D-LCR/A1_Main-Board/README.md

# D-LCR_A1_Main-Board
LCR Meter Analogue Main Board
