D-LCR/A1_Main-Board/Circuit/Main Board.kicad_pcb

## KiCad design Circuit/Main Board.kicad_pcb (2026-05-05)

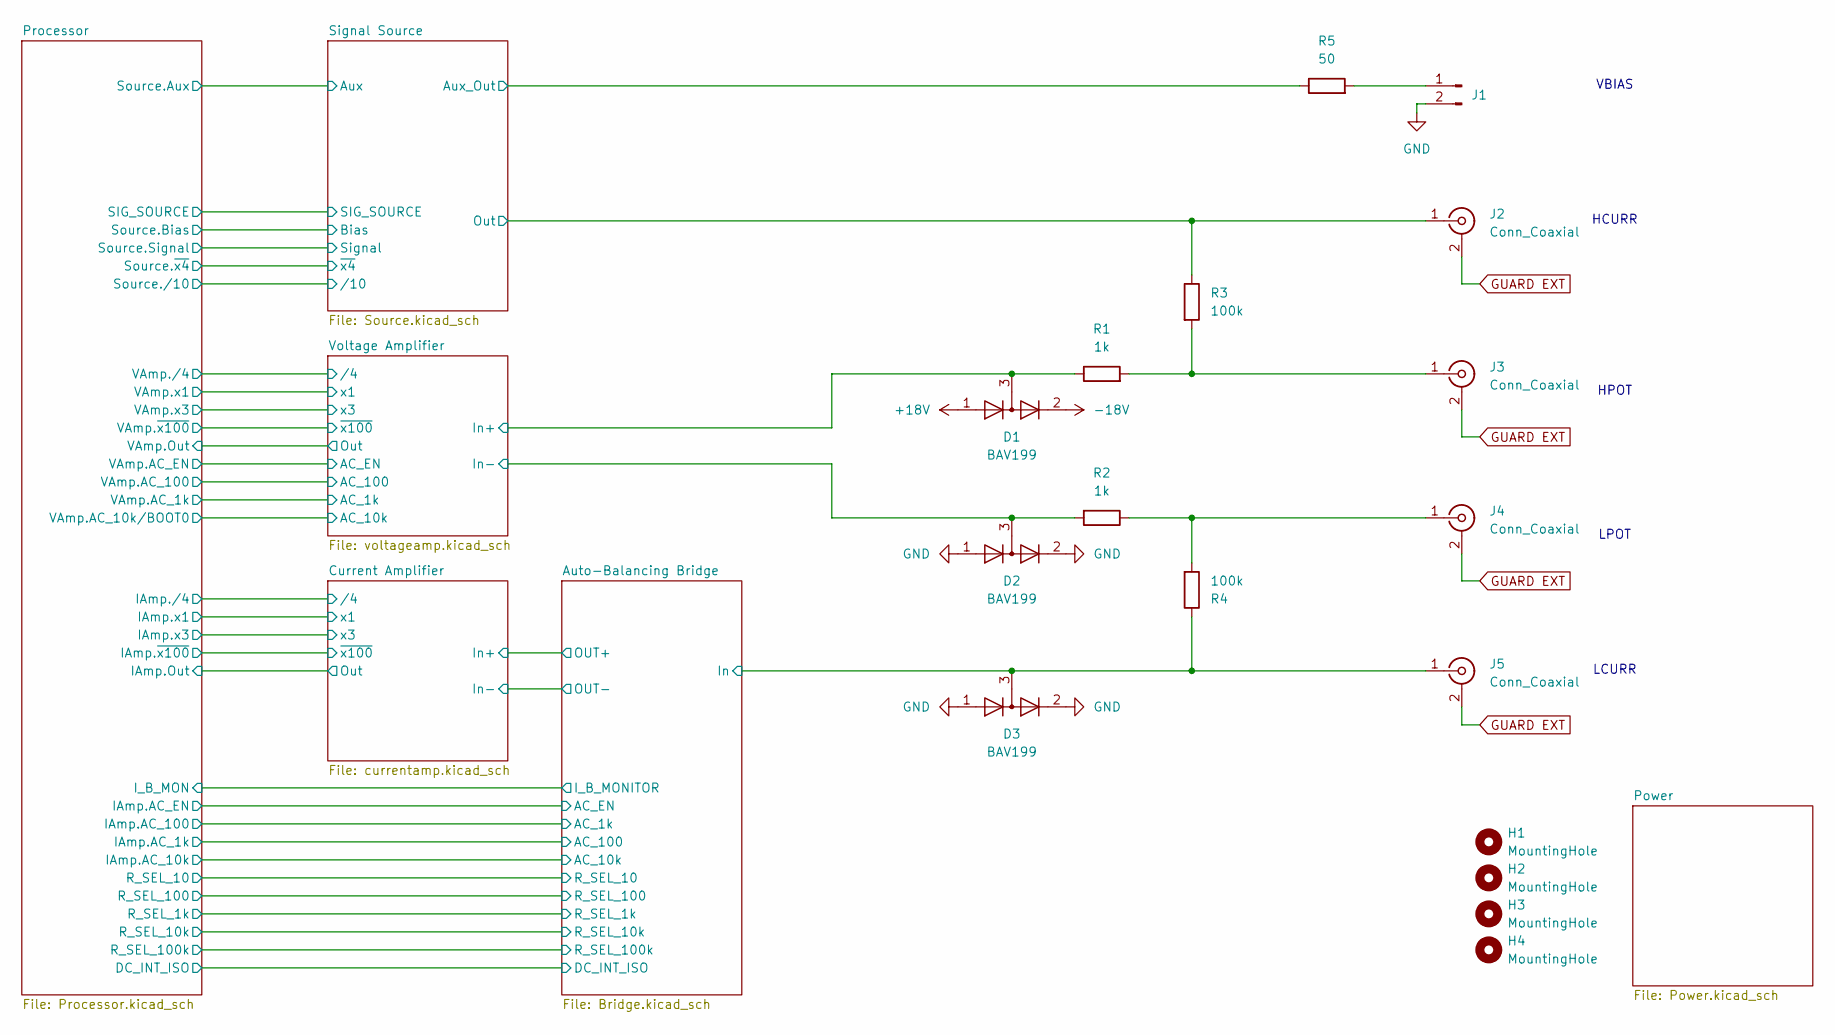
[picture p1: schematic Main Board.kicad_sch, Root]

Parts:
D1, D2, D3: BAV199; SOT-23
H1, H2, H3, H4: MountingHole; MountingHole_3.2mm_M3
J1: Conn_01x02_Pin; Molex_KK-254_AE-6410-02A_1x02_P2.54mm_Vertical
J2, J3, J4, J5: Conn_Coaxial; BNC_Amphenol_B6252HB-NPP3G-50_Horizontal
R1, R2: 1k; R_0805_2012Metric
R3, R4: 100k; R_0805_2012Metric
R5: 50; R_0805_2012Metric

Connections:
+18V: D1.1 (K); also elsewhere on the board
-18V: D1.2 (A); also elsewhere on the board
/Auto-Balancing Bridge/TIA_SUM: D3.3 (K), J5.1 (In), R4.1; also elsewhere on the board
/Signal Source/Aux_Out: R5.1; also elsewhere on the board
/Signal Source/Out: J2.1 (In), R3.1; also elsewhere on the board
/Voltage Amplifier/In+: D1.3 (K), R1.1; also elsewhere on the board
/Voltage Amplifier/In-: D2.3 (K), R2.2; also elsewhere on the board
GND: D2.1 (K), D2.2 (A), D3.1 (K), D3.2 (A), J1.2; also elsewhere on the board
GUARD EXT: J2.2 (Ext), J3.2 (Ext), J4.2 (Ext), J5.2 (Ext); also elsewhere on the board
unnamed: J1.1, R5.2
unnamed: J3.1 (In), R1.2, R3.2
unnamed: J4.1 (In), R2.1, R4.2

Notes on the sheet:
LPOT
HCURR
VBIAS
LCURR
HPOT

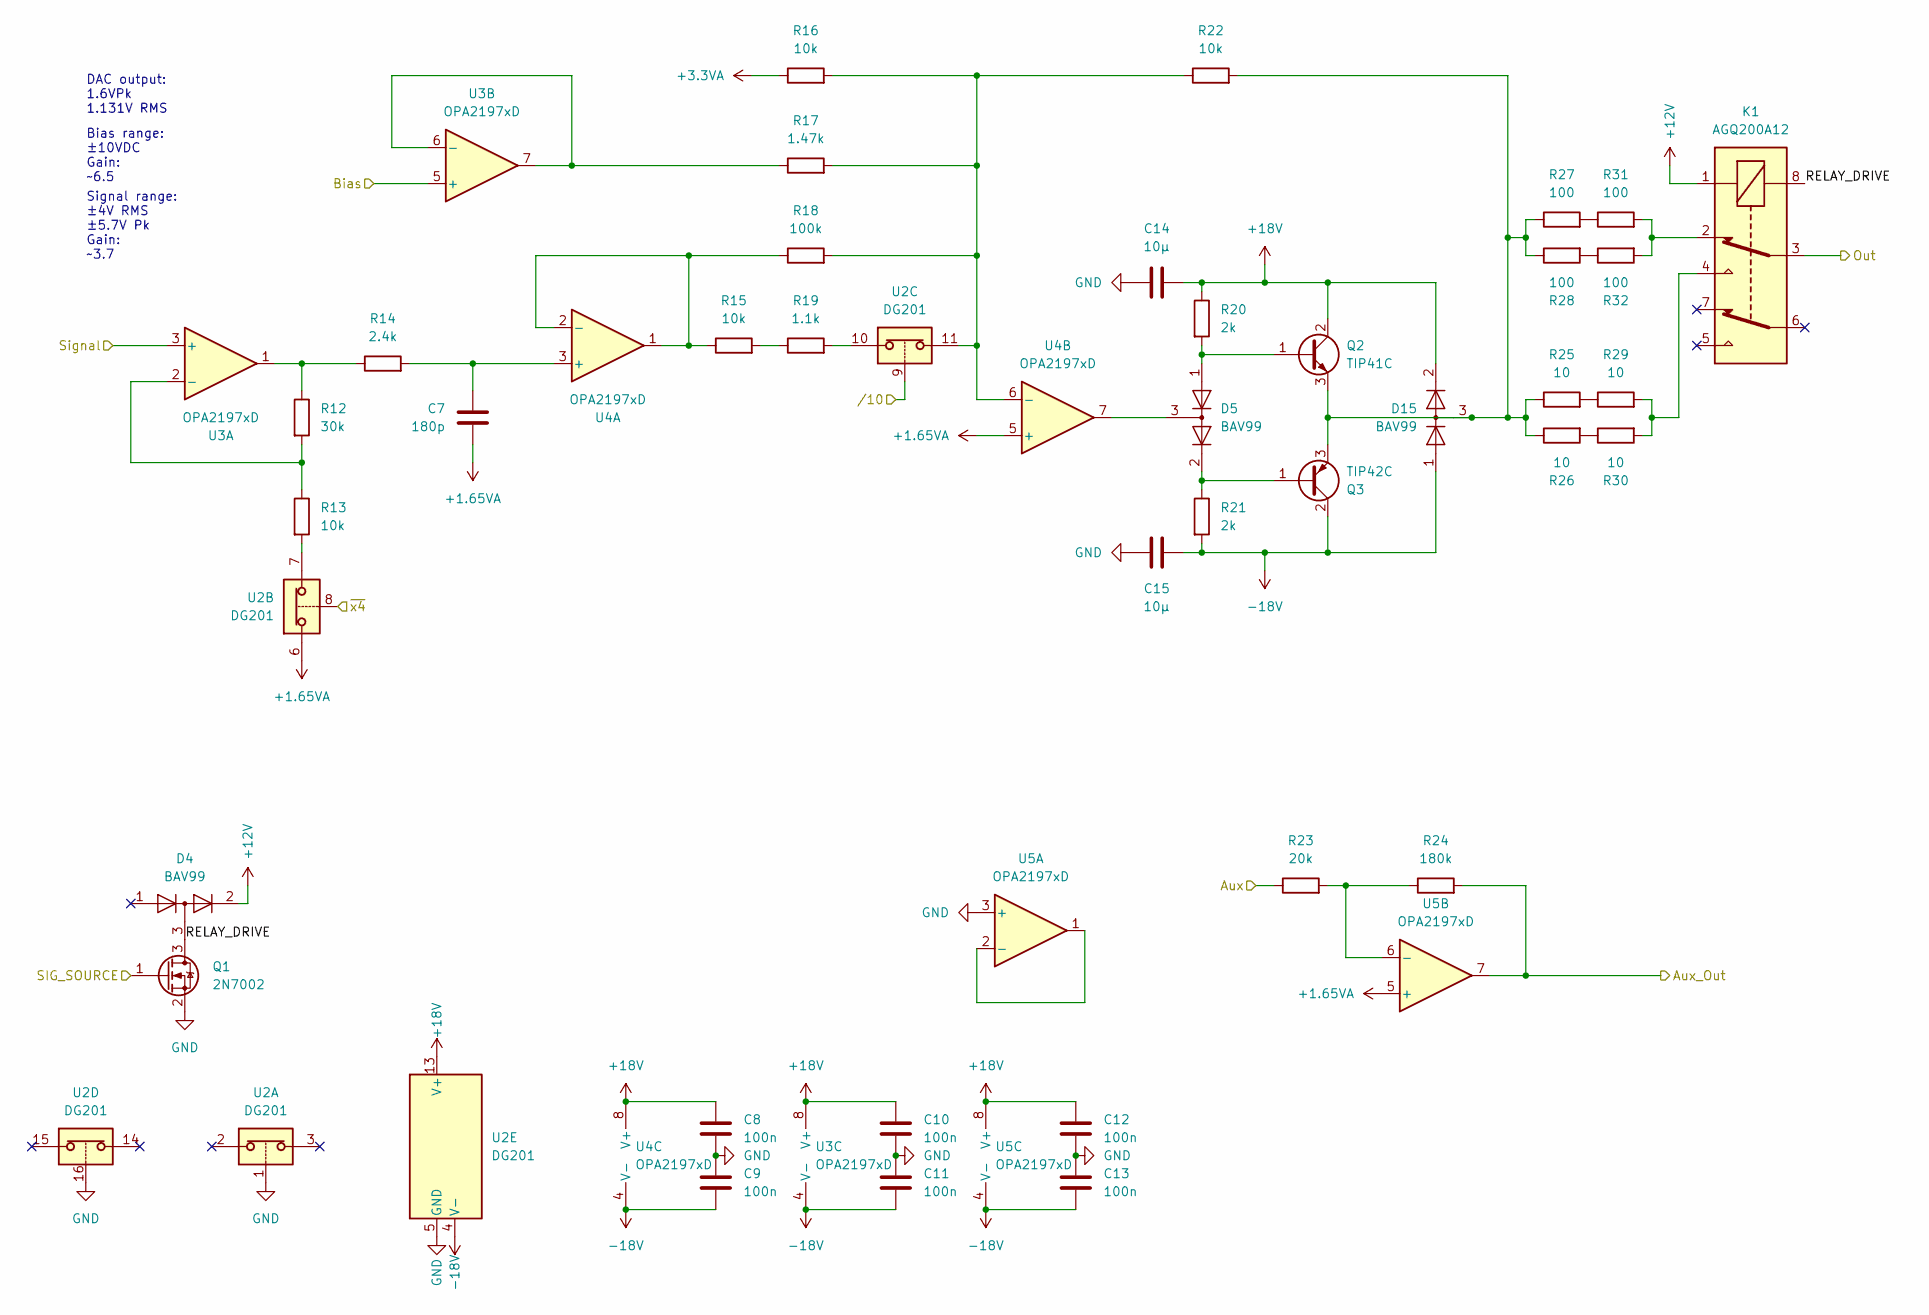
[picture p2: schematic Source.kicad_sch, Signal Source]

Parts:
C7: 180p; C_0805_2012Metric
C8, C9, C10, C11, C12, C13: 100n; C_0805_2012Metric
C14, C15: 10µ; C_0805_2012Metric
D4, D5, D15: BAV99; SOT-23
K1: AGQ200A12; RELAY_AGQ_A_PAN; Mouser Part Number 769-AGQ200A12
Q1: 2N7002; SOT-23
Q2: TIP41C; TO-220-3_Vertical
Q3: TIP42C; TO-220-3_Vertical
R12: 30k; R_0805_2012Metric
R13, R15, R16, R22: 10k; R_0805_2012Metric
R14: 2.4k; R_0805_2012Metric
R17: 1.47k; R_0805_2012Metric
R18: 100k; R_0805_2012Metric
R19: 1.1k; R_0805_2012Metric
R20, R21: 2k; R_0805_2012Metric
R23: 20k; R_0805_2012Metric
R24: 180k; R_0805_2012Metric
R25, R26, R29, R30: 10; R_2512_6332Metric
R27, R28, R31, R32: 100; R_0805_2012Metric
U2: DG201; SOIC-16_3.9x9.9mm_P1.27mm
U3, U4, U5: OPA2197xD; SOIC-8_3.9x4.9mm_P1.27mm

Connections:
+1.65VA: C7.2, U2.6, U4.5 (+), U5.5 (+); also elsewhere on the board
+3.3VA: R16.1; also elsewhere on the board
+12V: D4.2 (A), K1.1; also elsewhere on the board
+18V: C8.1, C10.1, C12.1, C14.2, D15.2 (A), Q2.2 (C), R20.1, U2.13 (V+), U3.8 (V+), U4.8 (V+), U5.8 (V+); also elsewhere on the board
-18V: C9.2, C11.2, C13.2, C15.2, D15.1 (K), Q3.2 (C), R21.2, U2.4 (V-), U3.4 (V-), U4.4 (V-), U5.4 (V-); also elsewhere on the board
/Processor/SIG_SOURCE: Q1.1 (G); also elsewhere on the board
/Processor/Source.Aux: R23.1; also elsewhere on the board
/Processor/Source.Bias: U3.5 (+); also elsewhere on the board
/Processor/Source.Signal: U3.3 (+); also elsewhere on the board
/Processor/Source./10: U2.9; also elsewhere on the board
/Processor/Source.~x4: U2.8; also elsewhere on the board
/Signal Source/Aux_Out: R24.2, U5.7; also elsewhere on the board
/Signal Source/Out: K1.3; also elsewhere on the board
/Signal Source/RELAY_DRIVE: D4.3 (K), K1.8, Q1.3 (D)
GND: C8.2, C9.1, C10.2, C11.1, C12.2, C13.1, C14.1, C15.1, Q1.2 (S), U2.1, U2.5 (GND), U2.16, U5.3 (+); also elsewhere on the board
unnamed: D5.2 (A), Q3.1 (B), R21.1
unnamed: D5.3 (K), U4.7
unnamed: K1.2, R31.2, R32.2
unnamed: K1.4, R29.2, R30.2
unnamed: D5.1 (K), Q2.1 (B), R20.2
unnamed: D15.3 (K), Q2.3 (E), Q3.3 (E), R22.2, R25.1, R26.1, R27.1, R28.1
unnamed: R12.1, R14.1, U3.1
unnamed: R13.2, U2.7
unnamed: R15.2, R19.1
unnamed: R19.2, U2.10
unnamed: R25.2, R29.1
unnamed: R26.2, R30.1
unnamed: R27.2, R31.1
unnamed: R28.2, R32.1
unnamed: R12.2, R13.1, U3.2 (-)
unnamed: R17.1, U3.6 (-), U3.7
unnamed: C7.1, R14.2, U4.3 (+)
unnamed: R15.1, R18.1, U4.1, U4.2 (-)
unnamed: R16.2, R17.2, R18.2, R22.1, U2.11, U4.6 (-)
unnamed: U5.1, U5.2 (-)
unnamed: R23.2, R24.1, U5.6 (-)

Notes on the sheet:
Bias range: ±10VDC Gain: ~6.5
DAC output: 1.6VPk 1.131V RMS
Signal range: ±4V RMS ±5.7V Pk Gain: ~3.7

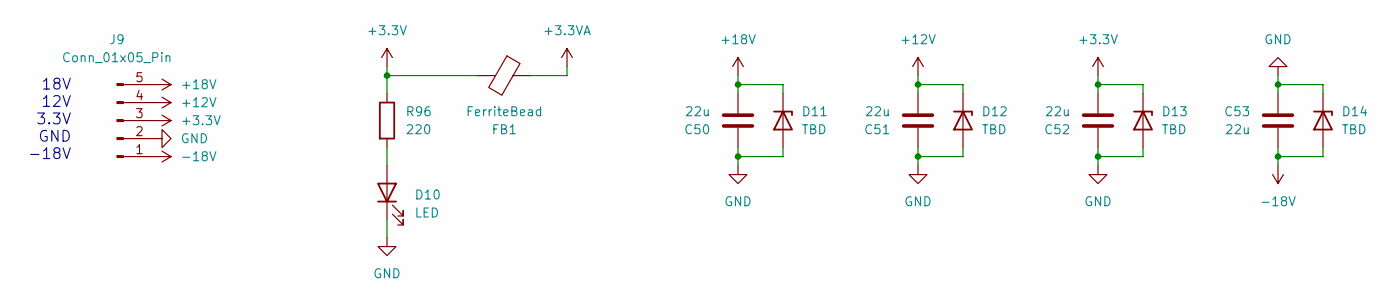
[picture p3: schematic Power.kicad_sch, Power Supply]

Parts:
C50, C51, C52, C53: 22u; C_1210_3225Metric
D10: LED; LED_0805_2012Metric
D11, D12, D13, D14: TBD; D_SMA
FB1: FerriteBead; L_0805_2012Metric
J9: Conn_01x05_Pin; Molex_KK-254_AE-6410-05A_1x05_P2.54mm_Vertical
R96: 220; R_0805_2012Metric

Connections:
+3.3V: C52.2, D13.1 (K), FB1.2, J9.3, R96.1; also elsewhere on the board
+3.3VA: FB1.1; also elsewhere on the board
+12V: C51.2, D12.1 (K), J9.4; also elsewhere on the board
+18V: C50.2, D11.1 (K), J9.5; also elsewhere on the board
-18V: C53.1, D14.2 (A), J9.1; also elsewhere on the board
GND: C50.1, C51.1, C52.1, C53.2, D10.1 (K), D11.2 (A), D12.2 (A), D13.2 (A), D14.1 (K), J9.2; also elsewhere on the board
unnamed: D10.2 (A), R96.2

Notes on the sheet:
18V 12V 3.3V GND -18V

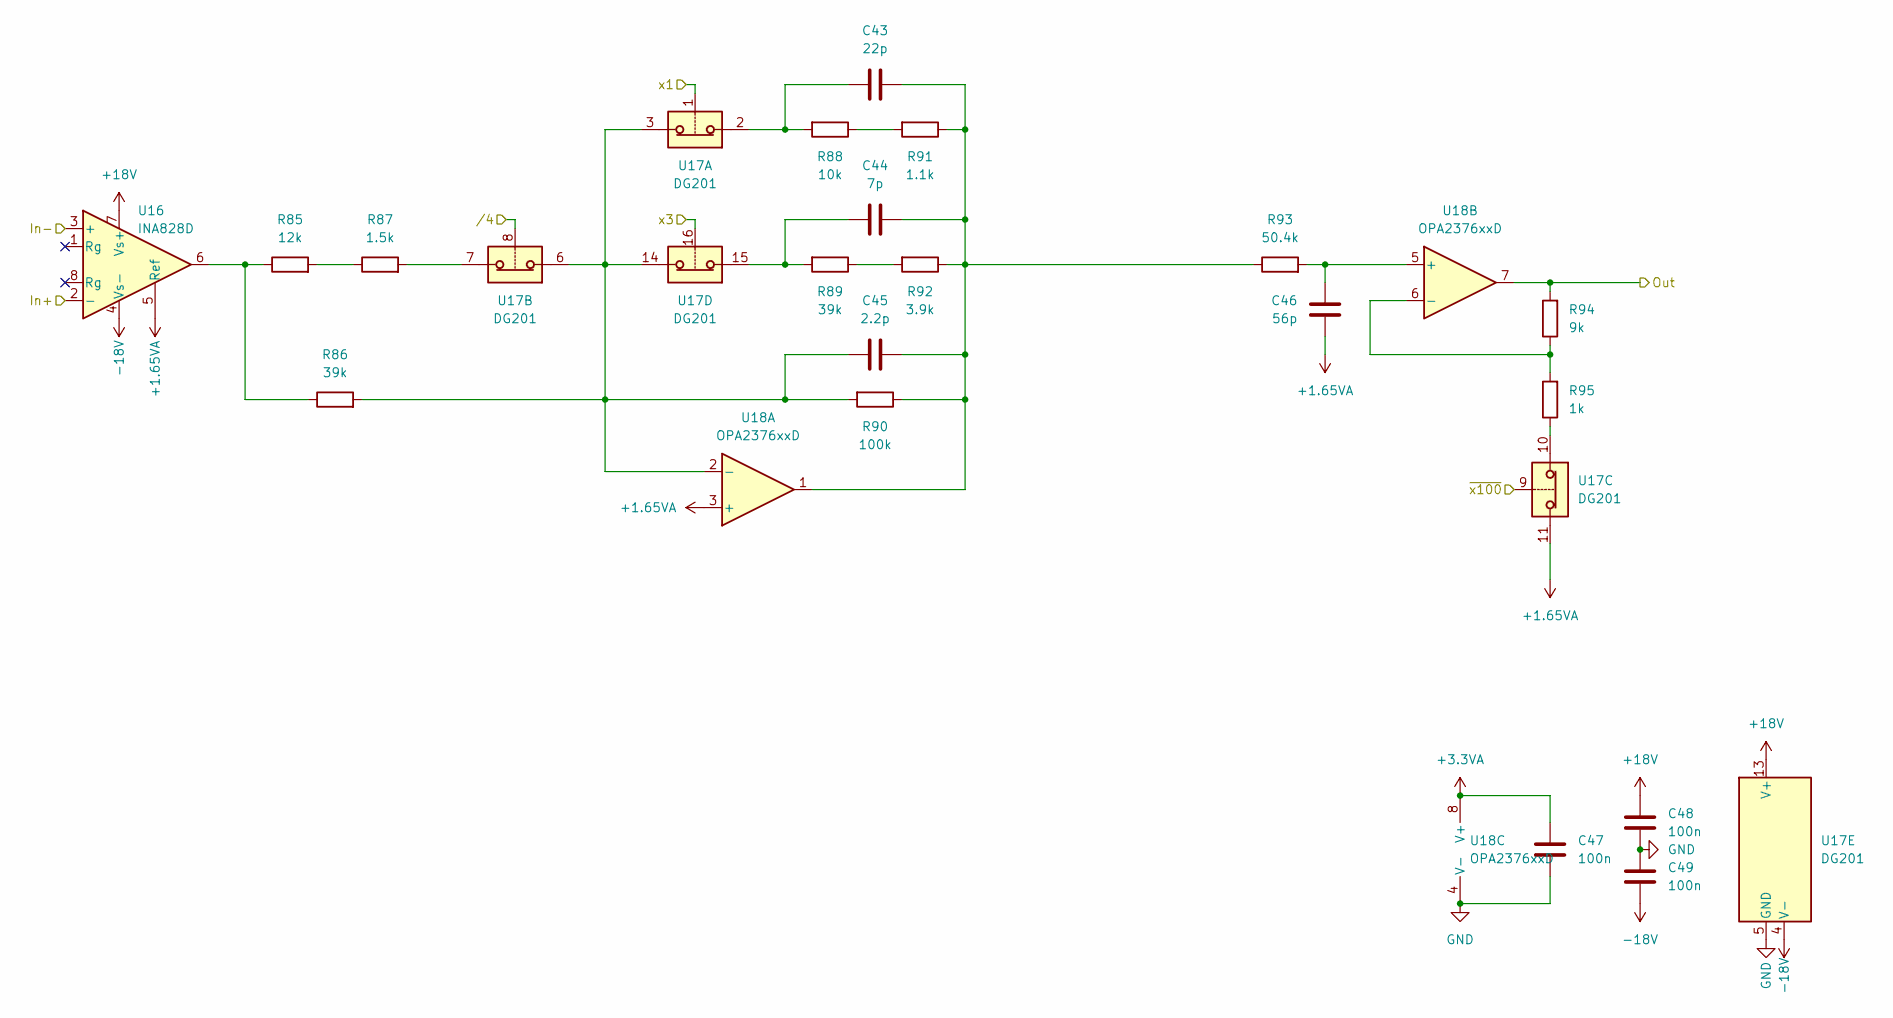
[picture p4: schematic currentamp.kicad_sch, Current Amplifier]

Parts:
C43: 22p; C_0805_2012Metric
C44: 7p; C_0805_2012Metric
C45: 2.2p; C_0805_2012Metric
C46: 56p; C_0805_2012Metric
C47, C48, C49: 100n; C_0805_2012Metric
R85: 12k; R_0805_2012Metric
R86, R89: 39k; R_0805_2012Metric
R87: 1.5k; R_0805_2012Metric
R88: 10k; R_0805_2012Metric
R90: 100k; R_0805_2012Metric
R91: 1.1k; R_0805_2012Metric
R92: 3.9k; R_0805_2012Metric
R93: 50.4k; R_0805_2012Metric
R94: 9k; R_0805_2012Metric
R95: 1k; R_0805_2012Metric
U16: INA828D; SOIC-8_3.9x4.9mm_P1.27mm
U17: DG201; SOIC-16_3.9x9.9mm_P1.27mm
U18: OPA2376xxD; SOIC-8_3.9x4.9mm_P1.27mm

Connections:
+1.65VA: C46.2, U16.5 (Ref), U17.11, U18.3 (+); also elsewhere on the board
+3.3VA: C47.1, U18.8 (V+); also elsewhere on the board
+18V: C48.1, U16.7 (Vs+), U17.13 (V+); also elsewhere on the board
-18V: C49.2, U16.4 (Vs-), U17.4 (V-); also elsewhere on the board
/Auto-Balancing Bridge/OUT+: U16.2 (-); also elsewhere on the board
/Auto-Balancing Bridge/TIA_SUM: U16.3 (+); also elsewhere on the board
/Current Amplifier/Out: R94.2, U18.7; also elsewhere on the board
/Current Amplifier/x1: U17.1; also elsewhere on the board
/Current Amplifier/x3: U17.16; also elsewhere on the board
/Current Amplifier//4: U17.8; also elsewhere on the board
/Current Amplifier/~x100: U17.9; also elsewhere on the board
GND: C47.2, C48.2, C49.1, U17.5 (GND), U18.4 (V-); also elsewhere on the board
unnamed: C43.1, R88.2, U17.2
unnamed: C43.2, C44.2, C45.2, R90.1, R91.1, R92.1, R93.1, U18.1
unnamed: C44.1, R89.2, U17.15
unnamed: R85.1, R86.1, U16.6
unnamed: R85.2, R87.1
unnamed: R87.2, U17.7
unnamed: R88.1, R91.2
unnamed: R89.1, R92.2
unnamed: R95.1, U17.10
unnamed: C45.1, R86.2, R90.2, U17.3, U17.6, U17.14, U18.2 (-)
unnamed: C46.1, R93.2, U18.5 (+)
unnamed: R94.1, R95.2, U18.6 (-)

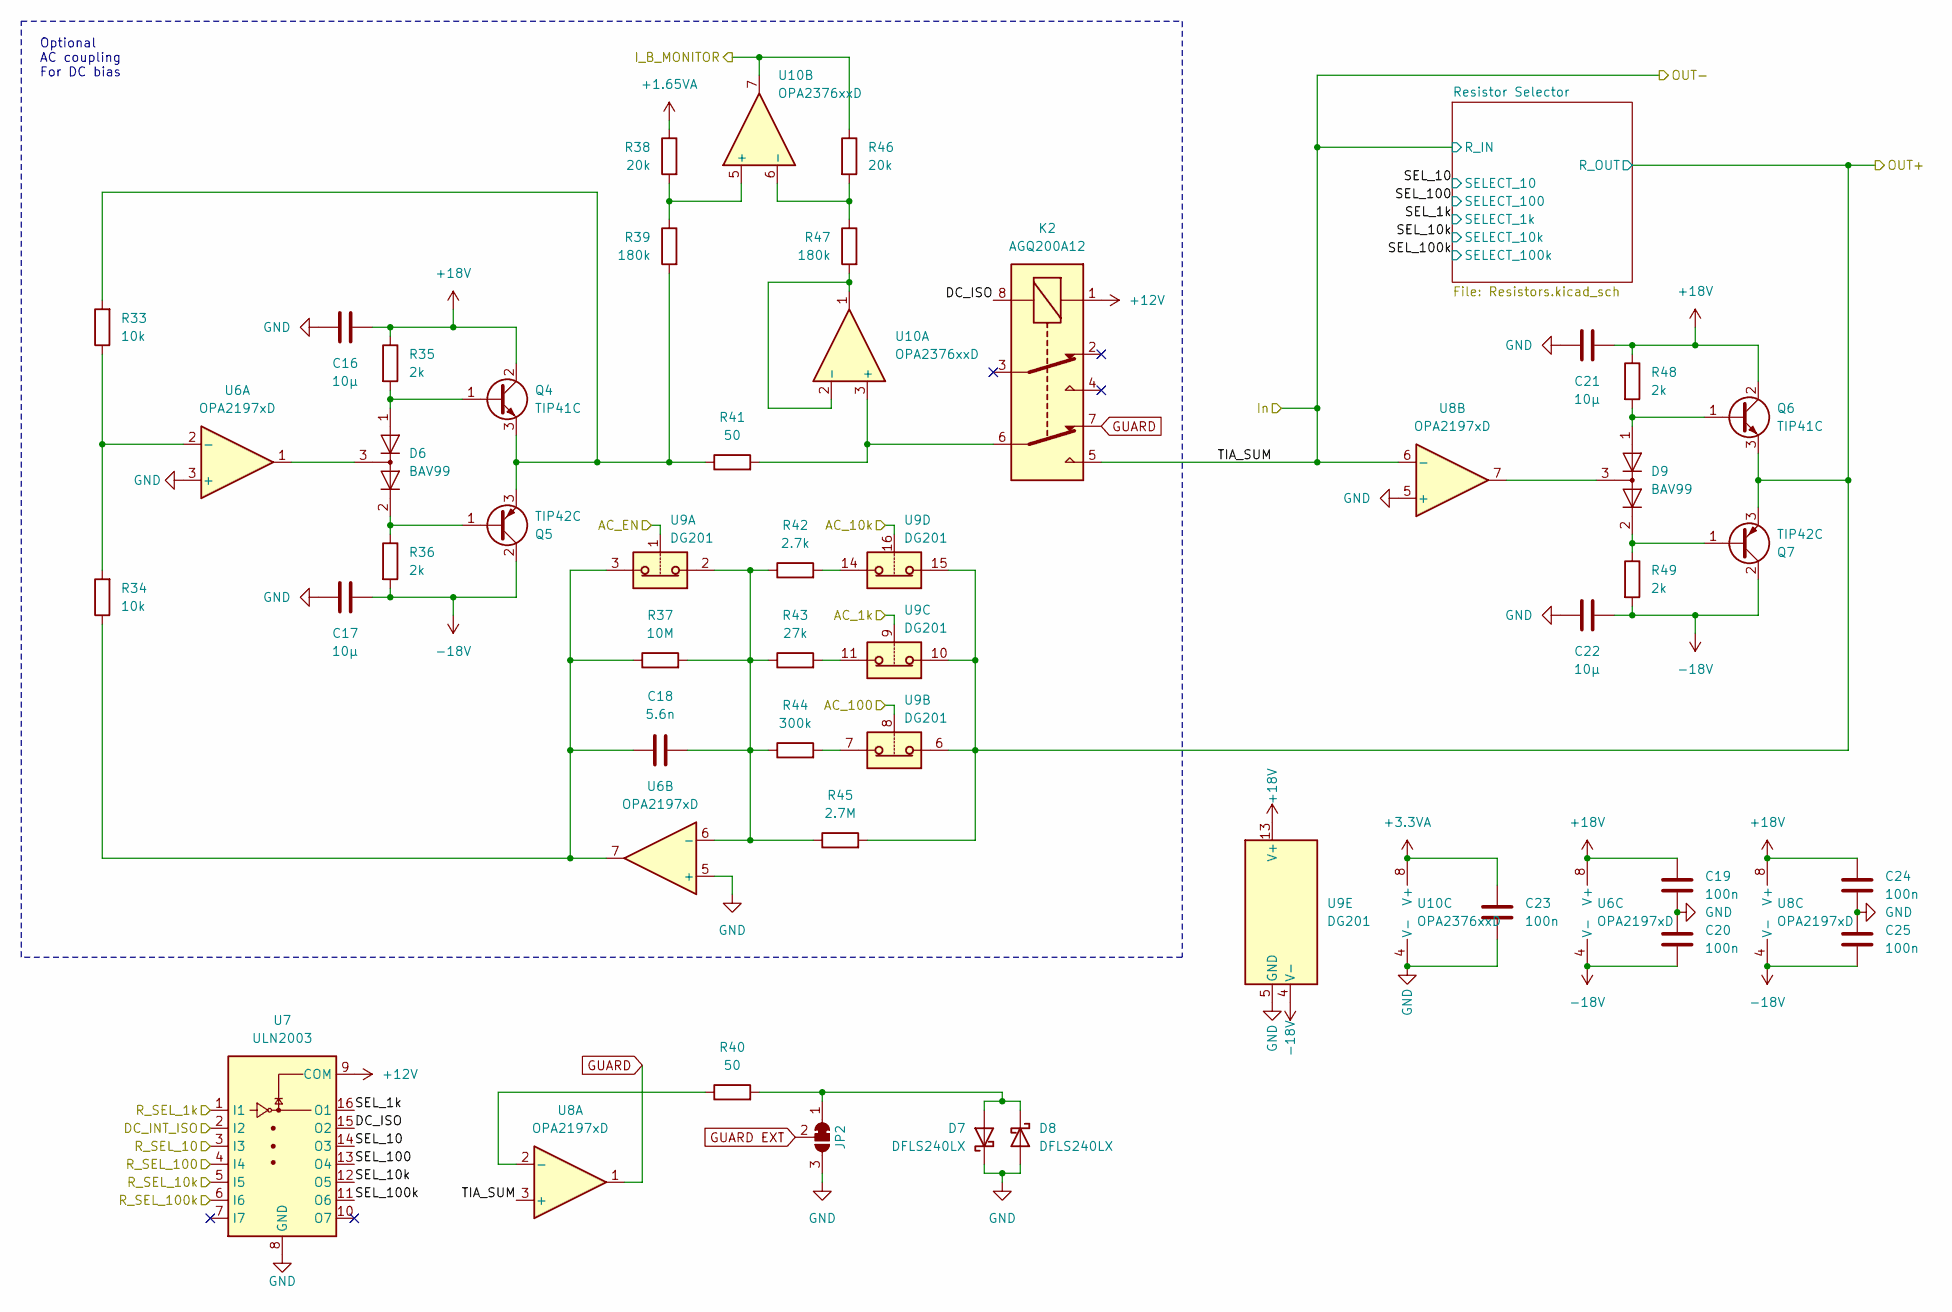
[picture p5: schematic Bridge.kicad_sch, Auto-Balancing Bridge]

Parts:
C16, C17, C21, C22: 10µ; C_0805_2012Metric
C18: 5.6n; C_0805_2012Metric
C19, C20, C23, C24, C25: 100n; C_0805_2012Metric
D6, D9: BAV99; SOT-23
D7, D8: DFLS240LX; D_PowerDI-123
JP2: SolderJumper_3_Bridged12; SolderJumper-3_P1.3mm_Bridged12_RoundedPad1.0x1.5mm
K2: AGQ200A12; RELAY_AGQ_A_PAN; Mouser Part Number 769-AGQ200A12
Q4, Q6: TIP41C; TO-220-3_Vertical
Q5, Q7: TIP42C; TO-220-3_Vertical
R33, R34: 10k; R_0805_2012Metric
R35, R36, R48, R49: 2k; R_0805_2012Metric
R37: 10M; R_0805_2012Metric
R38, R46: 20k; R_0805_2012Metric
R39, R47: 180k; R_0805_2012Metric
R40, R41: 50; R_0805_2012Metric
R42: 2.7k; R_0805_2012Metric
R43: 27k; R_0805_2012Metric
R44: 300k; R_0805_2012Metric
R45: 2.7M; R_0805_2012Metric
U6, U8: OPA2197xD; SOIC-8_3.9x4.9mm_P1.27mm
U7: ULN2003; SOIC-16_3.9x9.9mm_P1.27mm
U9: DG201; SOIC-16_3.9x9.9mm_P1.27mm
U10: OPA2376xxD; SOIC-8_3.9x4.9mm_P1.27mm

Connections:
+1.65VA: R38.1; also elsewhere on the board
+3.3VA: C23.1, U10.8 (V+); also elsewhere on the board
+12V: K2.1, U7.9 (COM); also elsewhere on the board
+18V: C16.2, C19.1, C21.2, C24.1, Q4.2 (C), Q6.2 (C), R35.1, R48.1, U6.8 (V+), U8.8 (V+), U9.13 (V+); also elsewhere on the board
-18V: C17.2, C20.2, C22.2, C25.2, Q5.2 (C), Q7.2 (C), R36.2, R49.2, U6.4 (V-), U8.4 (V-), U9.4 (V-); also elsewhere on the board
/Auto-Balancing Bridge/AC_1k: U9.9; also elsewhere on the board
/Auto-Balancing Bridge/AC_10k: U9.16; also elsewhere on the board
/Auto-Balancing Bridge/AC_100: U9.8; also elsewhere on the board
/Auto-Balancing Bridge/AC_EN: U9.1; also elsewhere on the board
/Auto-Balancing Bridge/DC_INT_ISO: U7.2 (I2); also elsewhere on the board
/Auto-Balancing Bridge/DC_ISO: K2.8, U7.15 (O2)
/Auto-Balancing Bridge/I_B_MONITOR: R46.1, U10.7; also elsewhere on the board
/Auto-Balancing Bridge/OUT+: Q6.3 (E), Q7.3 (E), R45.2, U9.6, U9.10, U9.15; also elsewhere on the board
/Auto-Balancing Bridge/R_SEL_1k: U7.1 (I1); also elsewhere on the board
/Auto-Balancing Bridge/R_SEL_10: U7.3 (I3); also elsewhere on the board
/Auto-Balancing Bridge/R_SEL_10k: U7.5 (I5); also elsewhere on the board
/Auto-Balancing Bridge/R_SEL_100: U7.4 (I4); also elsewhere on the board
/Auto-Balancing Bridge/R_SEL_100k: U7.6 (I6); also elsewhere on the board
/Auto-Balancing Bridge/SEL_1k: U7.16 (O1); also elsewhere on the board
/Auto-Balancing Bridge/SEL_10: U7.14 (O3); also elsewhere on the board
/Auto-Balancing Bridge/SEL_10k: U7.12 (O5); also elsewhere on the board
/Auto-Balancing Bridge/SEL_100: U7.13 (O4); also elsewhere on the board
/Auto-Balancing Bridge/SEL_100k: U7.11 (O6); also elsewhere on the board
/Auto-Balancing Bridge/TIA_SUM: K2.5, U8.3 (+), U8.6 (-); also elsewhere on the board
GND: C16.1, C17.1, C19.2, C20.1, C21.1, C22.1, C23.2, C24.2, C25.1, D7.1 (K), D8.2 (A), JP2.3 (B), U6.3 (+), U6.5 (+), U7.8 (GND), U8.5 (+), U9.5 (GND), U10.4 (V-); also elsewhere on the board
GUARD: K2.7, U8.1; also elsewhere on the board
GUARD EXT: JP2.2 (C); also elsewhere on the board
unnamed: C18.1, R34.1, R37.1, U6.7, U9.3
unnamed: D6.2 (A), Q5.1 (B), R36.1
unnamed: D6.3 (K), U6.1
unnamed: D7.2 (A), D8.1 (K), JP2.1 (A), R40.2
unnamed: D9.2 (A), Q7.1 (B), R49.1
unnamed: D9.3 (K), U8.7
unnamed: D6.1 (K), Q4.1 (B), R35.2
unnamed: Q4.3 (E), Q5.3 (E), R33.2, R39.2, R41.1
unnamed: D9.1 (K), Q6.1 (B), R48.2
unnamed: R42.2, U9.14
unnamed: R43.2, U9.11
unnamed: R44.2, U9.7
unnamed: R33.1, R34.2, U6.2 (-)
unnamed: C18.2, R37.2, R42.1, R43.1, R44.1, R45.1, U6.6 (-), U9.2
unnamed: R40.1, U8.2 (-)
unnamed: K2.6, R41.2, U10.3 (+)
unnamed: R47.2, U10.1, U10.2 (-)
unnamed: R38.2, R39.1, U10.5 (+)
unnamed: R46.2, R47.1, U10.6 (-)

Notes on the sheet:
Optional AC coupling For DC bias

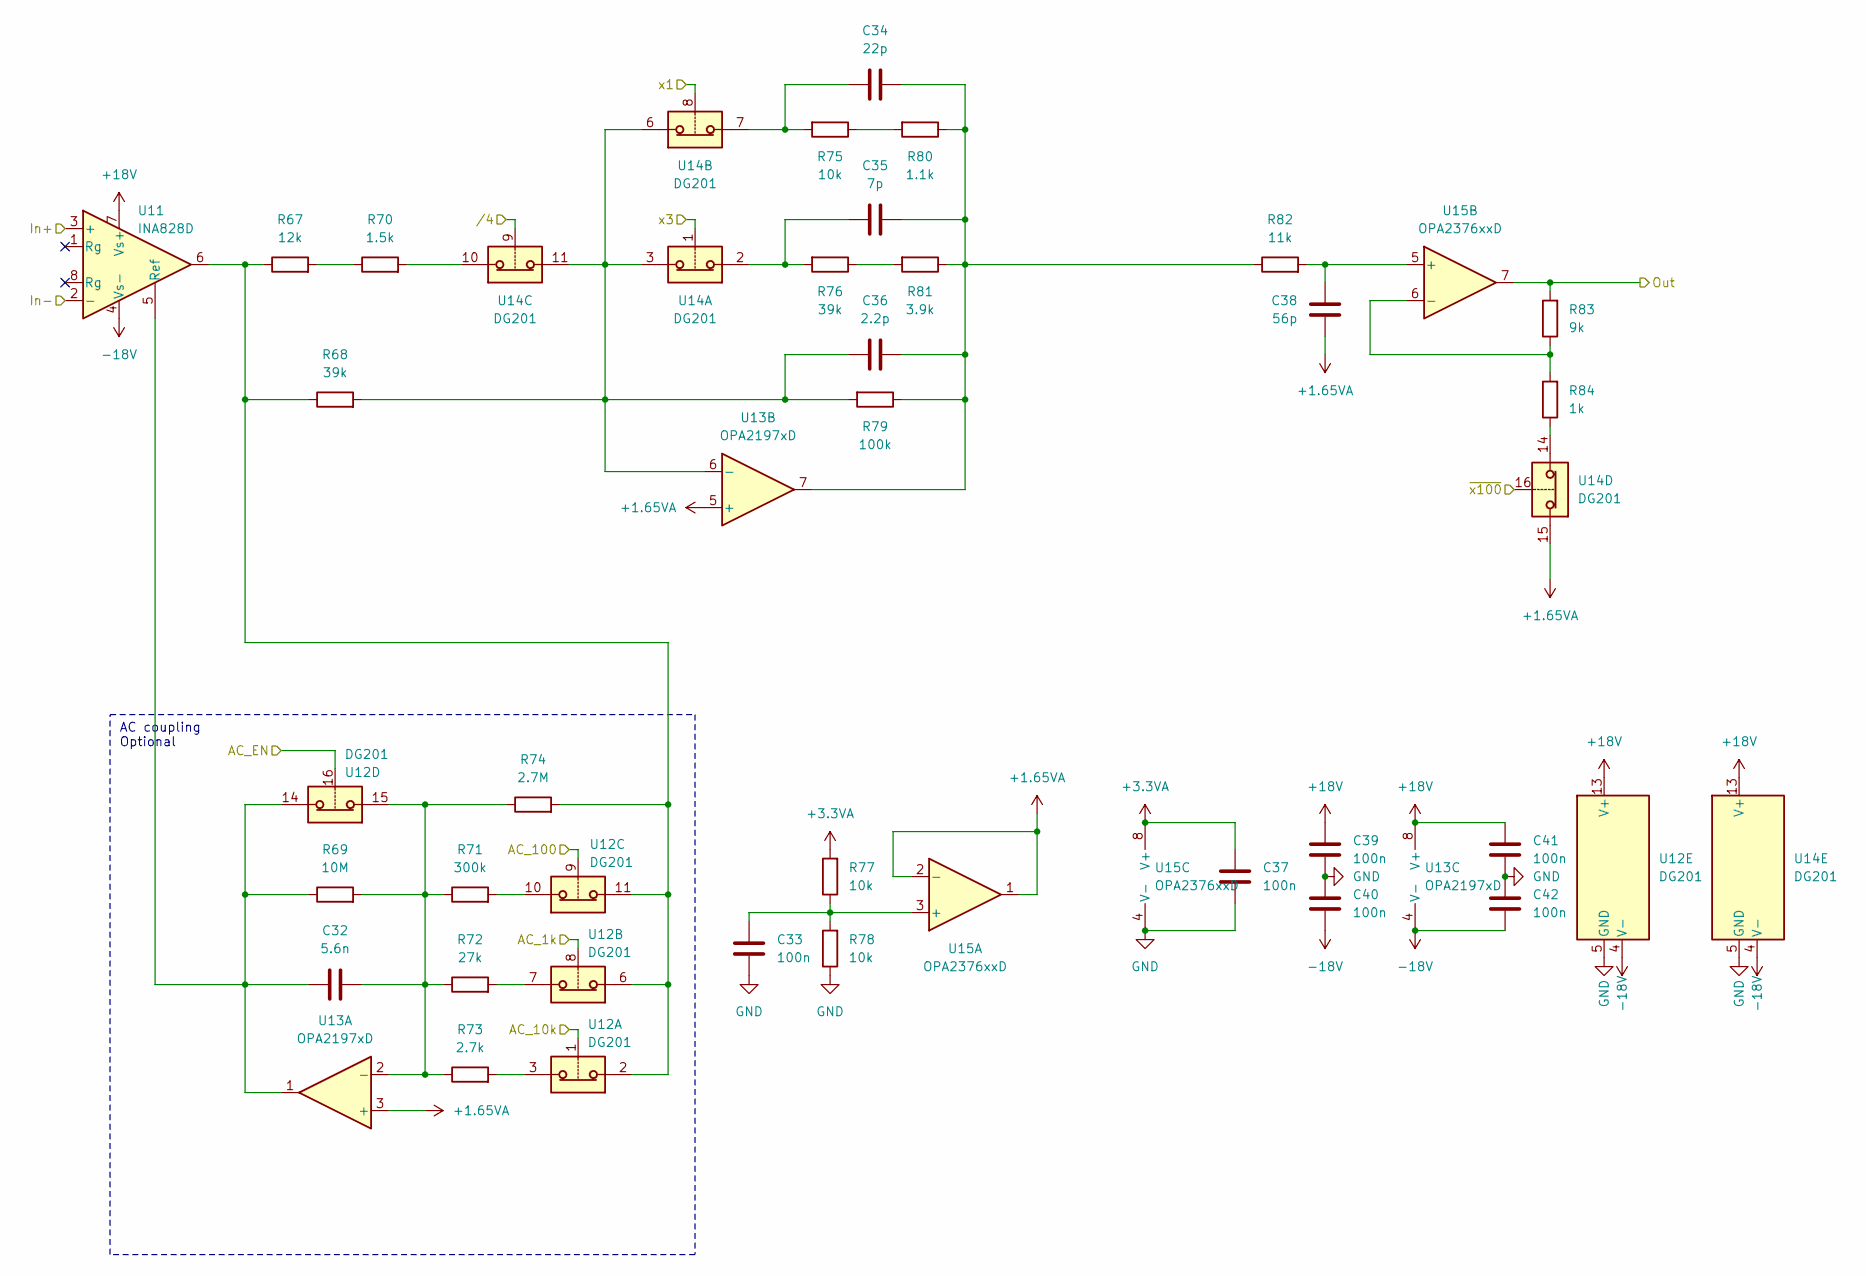
[picture p6: schematic voltageamp.kicad_sch, Voltage Amplifier]

Parts:
C32: 5.6n; C_0805_2012Metric
C33, C37, C39, C40, C41, C42: 100n; C_0805_2012Metric
C34: 22p; C_0805_2012Metric
C35: 7p; C_0805_2012Metric
C36: 2.2p; C_0805_2012Metric
C38: 56p; C_0805_2012Metric
R67: 12k; R_0805_2012Metric
R68, R76: 39k; R_0805_2012Metric
R69: 10M; R_0805_2012Metric
R70: 1.5k; R_0805_2012Metric
R71: 300k; R_0805_2012Metric
R72: 27k; R_0805_2012Metric
R73: 2.7k; R_0805_2012Metric
R74: 2.7M; R_0805_2012Metric
R75, R77, R78: 10k; R_0805_2012Metric
R79: 100k; R_0805_2012Metric
R80: 1.1k; R_0805_2012Metric
R81: 3.9k; R_0805_2012Metric
R82: 11k; R_0805_2012Metric
R83: 9k; R_0805_2012Metric
R84: 1k; R_0805_2012Metric
U11: INA828D; SOIC-8_3.9x4.9mm_P1.27mm
U12, U14: DG201; SOIC-16_3.9x9.9mm_P1.27mm
U13: OPA2197xD; SOIC-8_3.9x4.9mm_P1.27mm
U15: OPA2376xxD; SOIC-8_3.9x4.9mm_P1.27mm

Connections:
+1.65VA: C38.2, U13.3 (+), U13.5 (+), U14.15, U15.1, U15.2 (-); also elsewhere on the board
+3.3VA: C37.1, R77.2, U15.8 (V+); also elsewhere on the board
+18V: C39.1, C41.1, U11.7 (Vs+), U12.13 (V+), U13.8 (V+), U14.13 (V+); also elsewhere on the board
-18V: C40.2, C42.2, U11.4 (Vs-), U12.4 (V-), U13.4 (V-), U14.4 (V-); also elsewhere on the board
/Processor/VAmp.AC_1k: U12.8; also elsewhere on the board
/Processor/VAmp.AC_10k/BOOT0: U12.1; also elsewhere on the board
/Processor/VAmp.AC_100: U12.9; also elsewhere on the board
/Processor/VAmp.AC_EN: U12.16; also elsewhere on the board
/Processor/VAmp.Out: R83.2, U15.7; also elsewhere on the board
/Processor/VAmp.x1: U14.8; also elsewhere on the board
/Processor/VAmp.x3: U14.1; also elsewhere on the board
/Processor/VAmp./4: U14.9; also elsewhere on the board
/Processor/VAmp.~x100: U14.16; also elsewhere on the board
/Voltage Amplifier/In+: U11.3 (+); also elsewhere on the board
/Voltage Amplifier/In-: U11.2 (-); also elsewhere on the board
GND: C33.2, C37.2, C39.2, C40.1, C41.2, C42.1, R78.1, U12.5 (GND), U14.5 (GND), U15.4 (V-); also elsewhere on the board
unnamed: C34.1, R75.2, U14.7
unnamed: C34.2, C35.2, C36.2, R79.1, R80.1, R81.1, R82.1, U13.7
unnamed: C35.1, R76.2, U14.2
unnamed: R67.1, R68.1, R74.2, U11.6, U12.2, U12.6, U12.11
unnamed: R67.2, R70.1
unnamed: R70.2, U14.10
unnamed: R71.2, U12.10
unnamed: R72.2, U12.7
unnamed: R73.2, U12.3
unnamed: R75.1, R80.2
unnamed: R76.1, R81.2
unnamed: R84.1, U14.14
unnamed: C32.1, R69.1, U11.5 (Ref), U12.14, U13.1
unnamed: C32.2, R69.2, R71.1, R72.1, R73.1, R74.1, U12.15, U13.2 (-)
unnamed: C36.1, R68.2, R79.2, U13.6 (-), U14.3, U14.6, U14.11
unnamed: C33.1, R77.1, R78.2, U15.3 (+)
unnamed: C38.1, R82.2, U15.5 (+)
unnamed: R83.1, R84.2, U15.6 (-)

Notes on the sheet:
AC coupling Optional
