D-LCR/A1_Main-Board/Circuit/Main Board.kicad_pcb

## KiCad design Circuit/Main Board.kicad_pcb (continued)

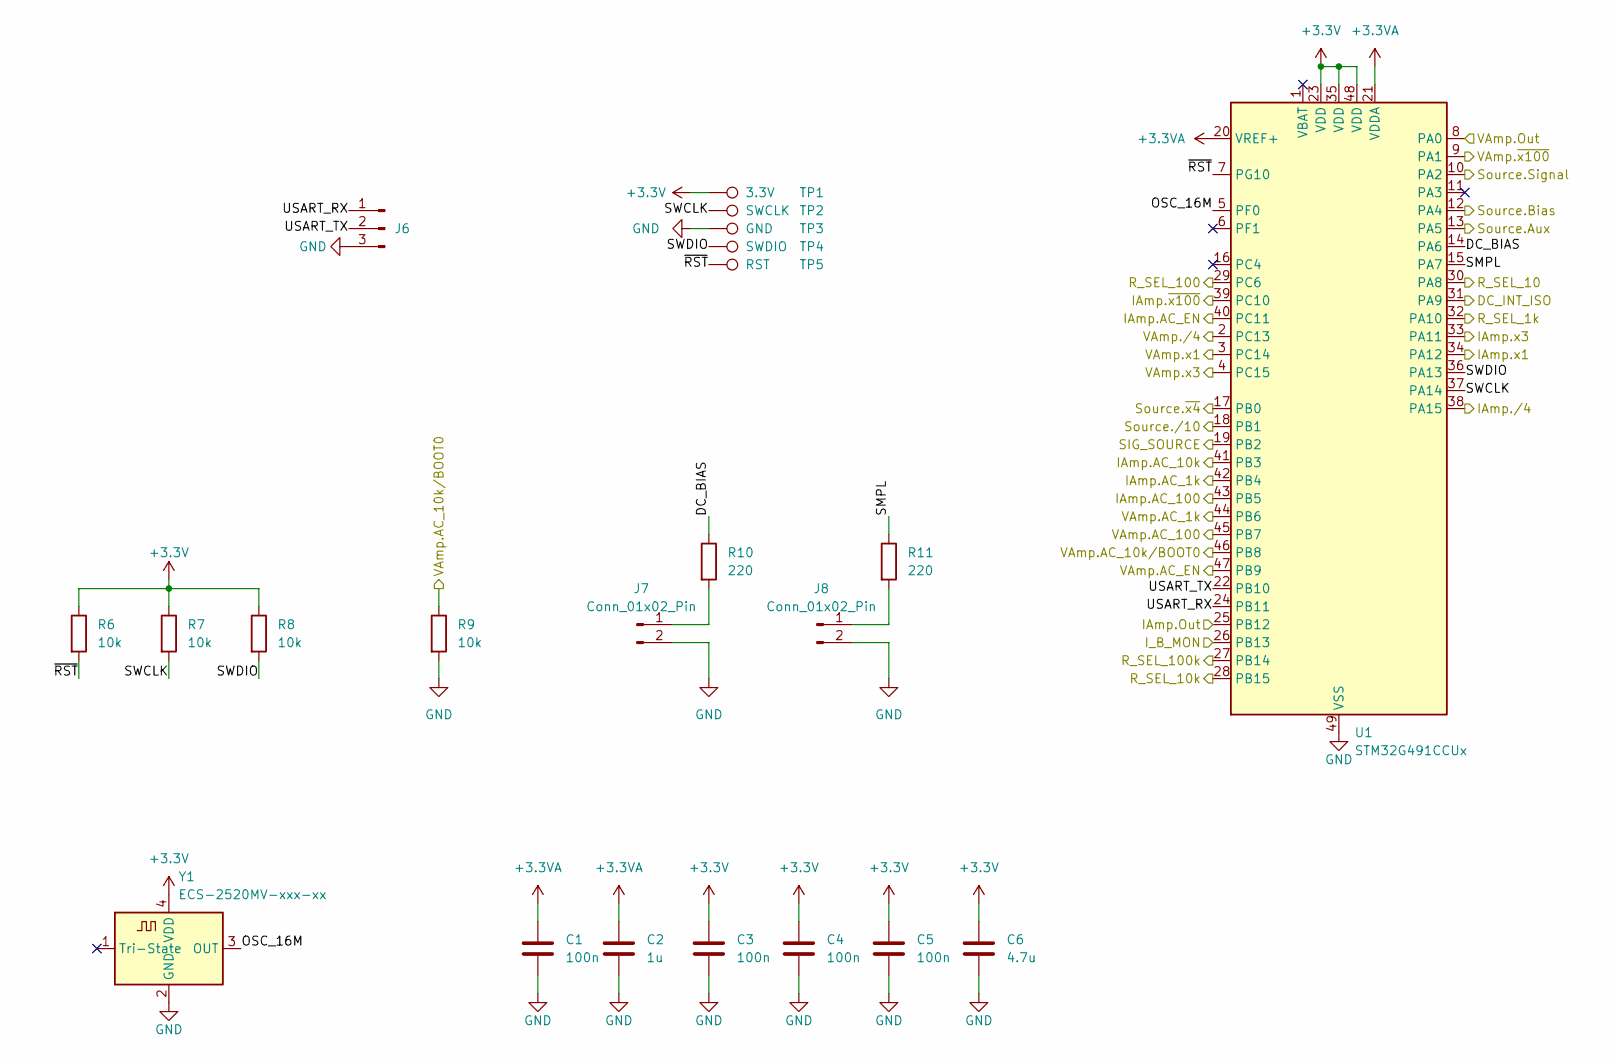
[picture p7: schematic Processor.kicad_sch]

Parts:
C1, C3, C4, C5: 100n; C_0805_2012Metric
C2: 1u; C_0805_2012Metric
C6: 4.7u; C_0805_2012Metric
J6: Conn_01x03_Pin; Molex_KK-254_AE-6410-03A_1x03_P2.54mm_Vertical
J7, J8: Conn_01x02_Pin; Molex_KK-254_AE-6410-02A_1x02_P2.54mm_Vertical
R6, R7, R8, R9: 10k; R_0805_2012Metric
R10, R11: 220; R_0805_2012Metric
TP1: 3.3V; TestPoint_Pad_2.0x2.0mm
TP2: SWCLK; TestPoint_Pad_2.0x2.0mm
TP3: GND; TestPoint_Pad_2.0x2.0mm
TP4: SWDIO; TestPoint_Pad_2.0x2.0mm
TP5: RST; TestPoint_Pad_2.0x2.0mm
U1: STM32G491CCUx; QFN-48-1EP_7x7mm_P0.5mm_EP5.6x5.6mm
Y1: ECS-2520MV-xxx-xx; Oscillator_SMD_ECS_2520MV-xxx-xx-4Pin_2.5x2.0mm

Connections:
+3.3V: C3.1, C4.1, C5.1, C6.1, R6.1, R7.1, R8.1, TP1.1 (1_1), U1.23 (VDD), U1.35 (VDD), U1.48 (VDD), Y1.4 (VDD); also elsewhere on the board
+3.3VA: C1.1, C2.1, U1.20 (VREF+), U1.21 (VDDA); also elsewhere on the board
/Auto-Balancing Bridge/AC_1k: U1.43 (PB5); also elsewhere on the board
/Auto-Balancing Bridge/AC_10k: U1.41 (PB3); also elsewhere on the board
/Auto-Balancing Bridge/AC_100: U1.42 (PB4); also elsewhere on the board
/Auto-Balancing Bridge/AC_EN: U1.40 (PC11); also elsewhere on the board
/Auto-Balancing Bridge/DC_INT_ISO: U1.31 (PA9); also elsewhere on the board
/Auto-Balancing Bridge/I_B_MONITOR: U1.26 (PB13); also elsewhere on the board
/Auto-Balancing Bridge/R_SEL_1k: U1.32 (PA10); also elsewhere on the board
/Auto-Balancing Bridge/R_SEL_10: U1.30 (PA8); also elsewhere on the board
/Auto-Balancing Bridge/R_SEL_10k: U1.28 (PB15); also elsewhere on the board
/Auto-Balancing Bridge/R_SEL_100: U1.29 (PC6); also elsewhere on the board
/Auto-Balancing Bridge/R_SEL_100k: U1.27 (PB14); also elsewhere on the board
/Current Amplifier/Out: U1.25 (PB12); also elsewhere on the board
/Current Amplifier/x1: U1.34 (PA12); also elsewhere on the board
/Current Amplifier/x3: U1.33 (PA11); also elsewhere on the board
/Current Amplifier//4: U1.38 (PA15); also elsewhere on the board
/Current Amplifier/~x100: U1.39 (PC10); also elsewhere on the board
/Processor/DC_BIAS: R10.1, U1.14 (PA6)
/Processor/OSC_16M: U1.5 (PF0), Y1.3 (OUT)
/Processor/SIG_SOURCE: U1.19 (PB2); also elsewhere on the board
/Processor/SMPL: R11.1, U1.15 (PA7)
/Processor/SWCLK: R7.2, TP2.1 (1_1), U1.37 (PA14)
/Processor/SWDIO: R8.2, TP4.1 (1_1), U1.36 (PA13)
/Processor/Source.Aux: U1.13 (PA5); also elsewhere on the board
/Processor/Source.Bias: U1.12 (PA4); also elsewhere on the board
/Processor/Source.Signal: U1.10 (PA2); also elsewhere on the board
/Processor/Source./10: U1.18 (PB1); also elsewhere on the board
/Processor/Source.~x4: U1.17 (PB0); also elsewhere on the board
/Processor/USART_RX: J6.1, U1.24 (PB11)
/Processor/USART_TX: J6.2, U1.22 (PB10)
/Processor/VAmp.AC_1k: U1.44 (PB6); also elsewhere on the board
/Processor/VAmp.AC_10k/BOOT0: R9.1, U1.46 (PB8); also elsewhere on the board
/Processor/VAmp.AC_100: U1.45 (PB7); also elsewhere on the board
/Processor/VAmp.AC_EN: U1.47 (PB9); also elsewhere on the board
/Processor/VAmp.Out: U1.8 (PA0); also elsewhere on the board
/Processor/VAmp.x1: U1.3 (PC14); also elsewhere on the board
/Processor/VAmp.x3: U1.4 (PC15); also elsewhere on the board
/Processor/VAmp./4: U1.2 (PC13); also elsewhere on the board
/Processor/VAmp.~x100: U1.9 (PA1); also elsewhere on the board
/Processor/~RST: R6.2, TP5.1 (1_1), U1.7 (PG10)
GND: C1.2, C2.2, C3.2, C4.2, C5.2, C6.2, J6.3, J7.2, J8.2, R9.2, TP3.1 (1_1), U1.49 (VSS), Y1.2 (GND); also elsewhere on the board
unnamed: J7.1, R10.2
unnamed: J8.1, R11.2

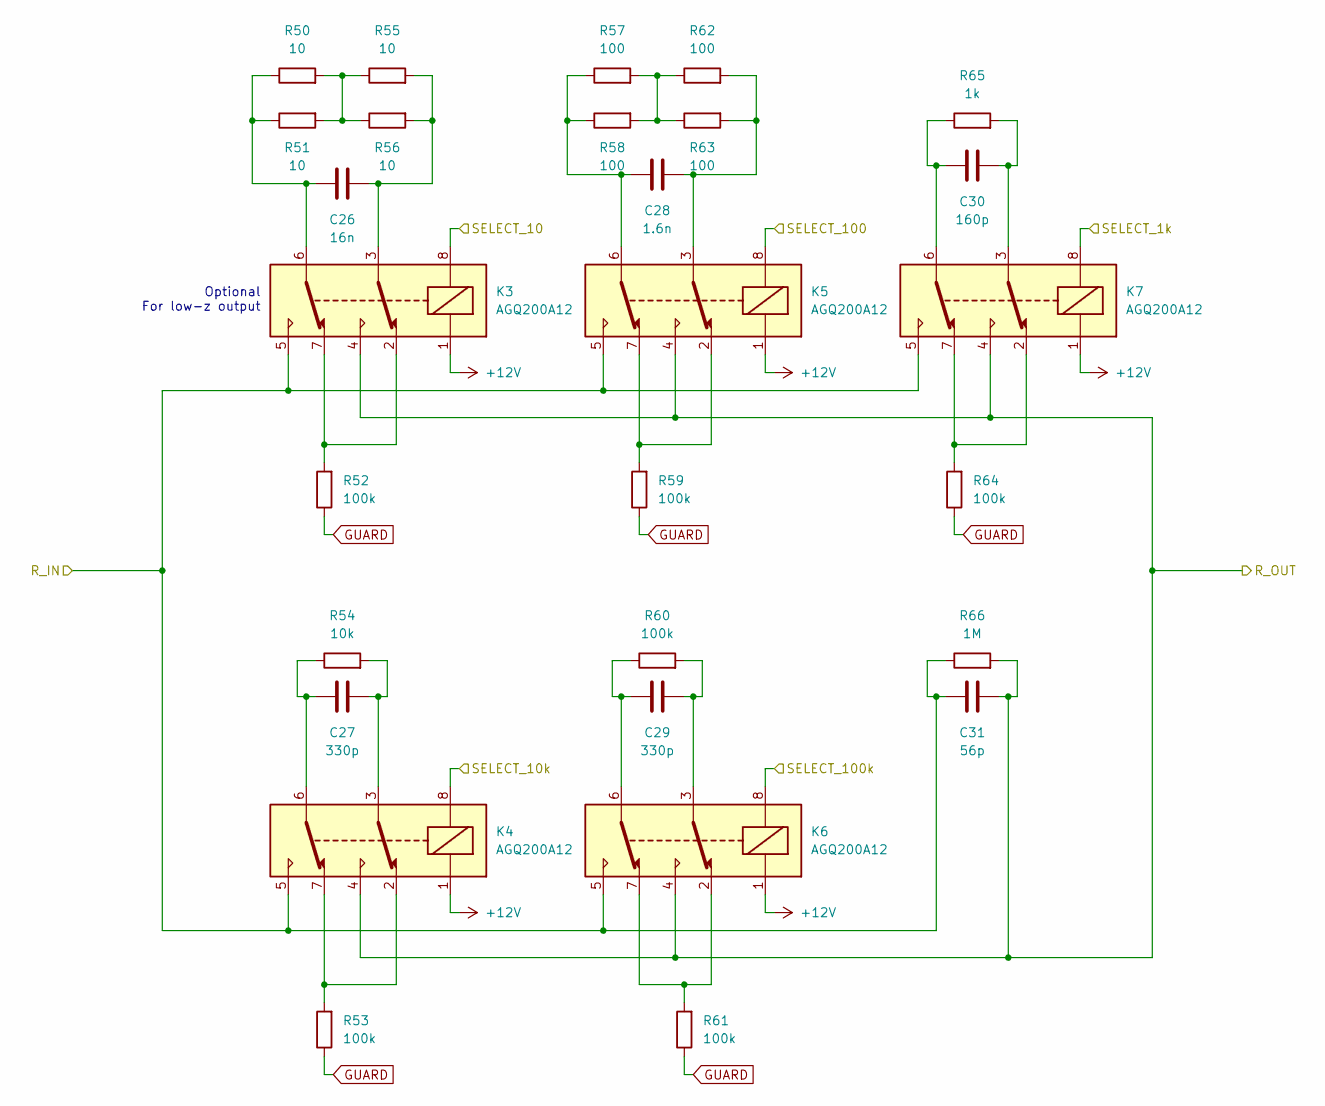
[picture p8: schematic Resistors.kicad_sch, Resistor Selector]

Parts:
C26: 16n; C_0805_2012Metric
C27, C29: 330p; C_0805_2012Metric
C28: 1.6n; C_0805_2012Metric
C30: 160p; C_0805_2012Metric
C31: 56p; C_0805_2012Metric
K3, K4, K5, K6, K7: AGQ200A12; RELAY_AGQ_A_PAN; Mouser Part Number 769-AGQ200A12
R50, R51, R55, R56: 10; R_2512_6332Metric
R52, R53, R59, R60, R61, R64: 100k; R_0805_2012Metric
R54: 10k; R_0805_2012Metric
R57, R58, R62, R63: 100; R_0805_2012Metric
R65: 1k; R_0805_2012Metric
R66: 1M; R_0805_2012Metric

Connections:
+12V: K3.1, K4.1, K5.1, K6.1, K7.1; also elsewhere on the board
/Auto-Balancing Bridge/OUT+: C31.2, K3.4, K4.4, K5.4, K6.4, K7.4, R66.2; also elsewhere on the board
/Auto-Balancing Bridge/SEL_1k: K7.8; also elsewhere on the board
/Auto-Balancing Bridge/SEL_10: K3.8; also elsewhere on the board
/Auto-Balancing Bridge/SEL_10k: K4.8; also elsewhere on the board
/Auto-Balancing Bridge/SEL_100: K5.8; also elsewhere on the board
/Auto-Balancing Bridge/SEL_100k: K6.8; also elsewhere on the board
/Auto-Balancing Bridge/TIA_SUM: C31.1, K3.5, K4.5, K5.5, K6.5, K7.5, R66.1; also elsewhere on the board
GUARD: R52.1, R53.1, R59.1, R61.1, R64.1; also elsewhere on the board
unnamed: C26.1, K3.6, R50.1, R51.1
unnamed: C26.2, K3.3, R55.2, R56.2
unnamed: C27.1, K4.6, R54.1
unnamed: C27.2, K4.3, R54.2
unnamed: C28.1, K5.6, R57.1, R58.1
unnamed: C28.2, K5.3, R62.2, R63.2
unnamed: C29.1, K6.6, R60.1
unnamed: C29.2, K6.3, R60.2
unnamed: C30.1, K7.6, R65.1
unnamed: C30.2, K7.3, R65.2
unnamed: K3.2, K3.7, R52.2
unnamed: K4.2, K4.7, R53.2
unnamed: K5.2, K5.7, R59.2
unnamed: K6.2, K6.7, R61.2
unnamed: K7.2, K7.7, R64.2
unnamed: R50.2, R51.2, R55.1, R56.1
unnamed: R57.2, R58.2, R62.1, R63.1

Notes on the sheet:
Optional For low-z output

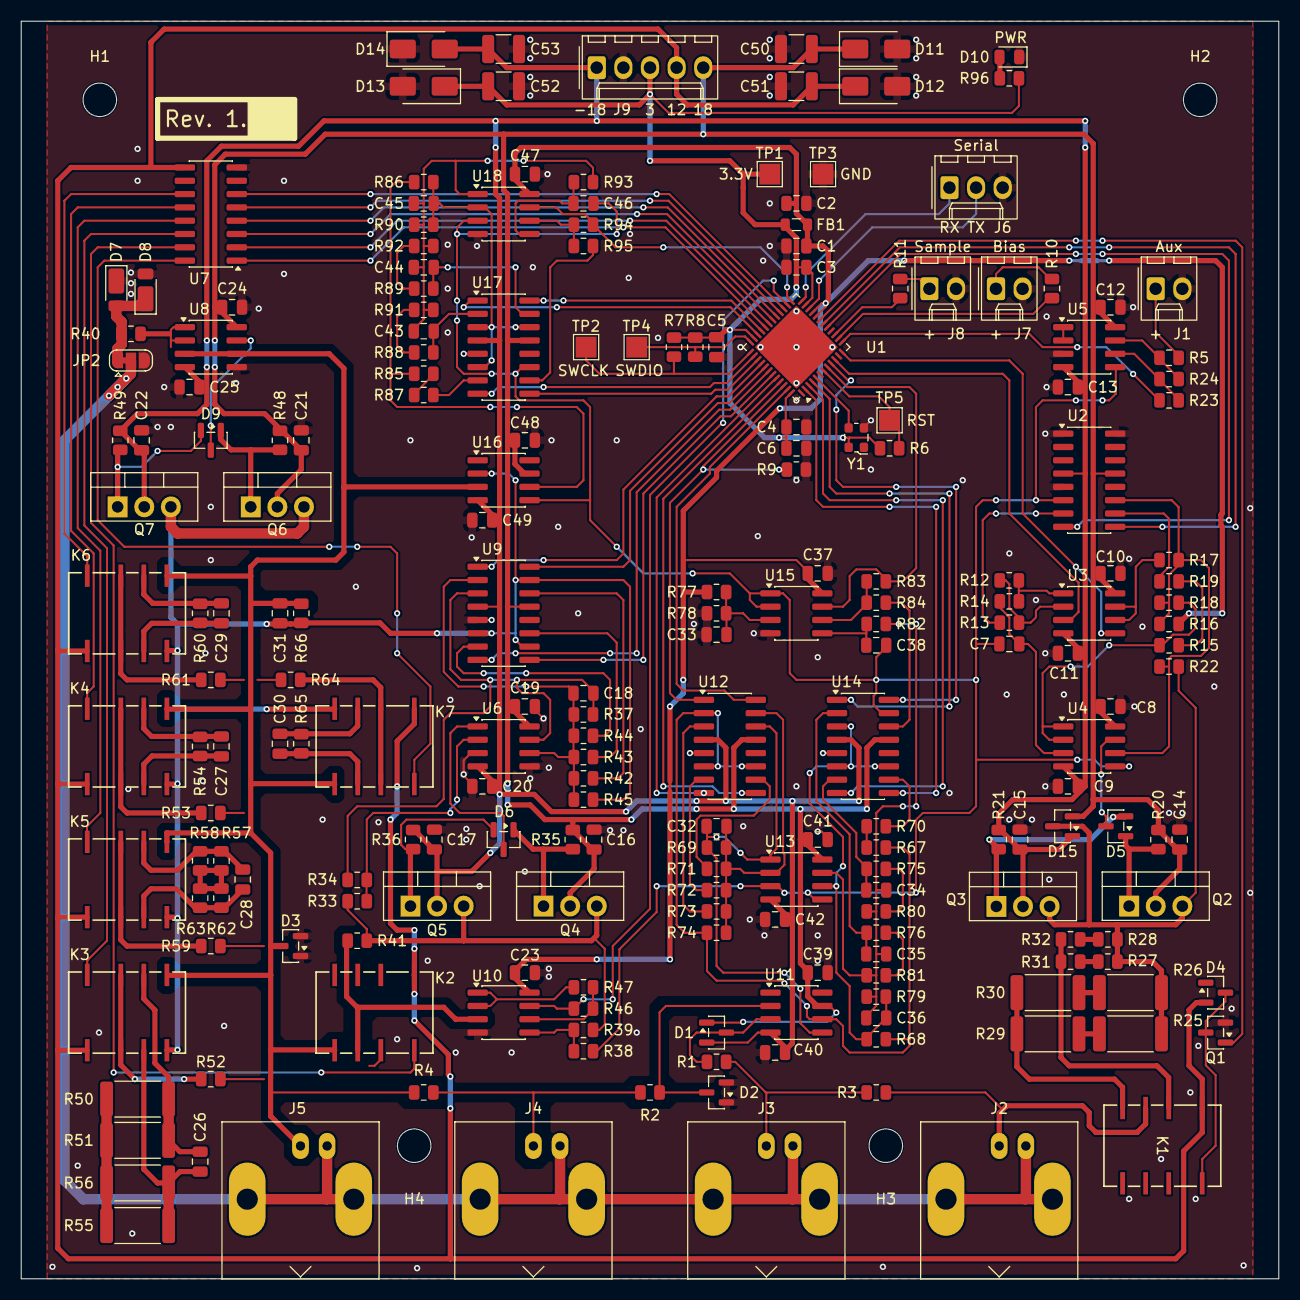
[picture p9: board Main Board.kicad_pcb from above]

Board: 2 copper layers, 120.0 x 120.0 mm, 217 parts (0 on the bottom side), 154 nets.
