D-LCR/A1_Main-Board/(commit log)

2026-05-02 Output job, Revision Box and reorganise
    [Bridge.kicad_sch, Main Board.kicad_pcb, Main Board.kicad_sch, Power.kicad_sch, Processor.kicad_sch, Resistors.kicad_sch, Source.kicad_sch, currentamp.kicad_sch]
2026-05-02 Update Main Board.kicad_pcb
    [Main Board.kicad_pcb]
2026-05-04 Input Protection Second Attempt
    [Bridge.kicad_sch, Main Board.kicad_pcb, Main Board.kicad_sch, Power.kicad_sch, Processor.kicad_sch, Resistors.kicad_sch, Source.kicad_sch, currentamp.kicad_sch]
2026-05-04 New Resistor Selection Circuit
    [Bridge.kicad_sch, Main Board.kicad_pcb, Main Board.kicad_sch, Power.kicad_sch, Processor.kicad_sch, Resistors.kicad_sch, currentamp.kicad_sch, voltageamp.kicad_sch]
2026-05-04 Fix Soldermask Errors
    [Main Board.kicad_pcb]
2026-05-05 Migrate to KiCAD V10
    [Bridge.kicad_sch, Main Board.kicad_sch, Power.kicad_sch, Processor.kicad_sch, Resistors.kicad_sch, Source.kicad_sch, currentamp.kicad_sch, voltageamp.kicad_sch]
2026-05-05 Final Touches
    [Main Board.kicad_pcb, Power.kicad_sch]
